LaskaKit/ESP32-C3_OLED_kit/img/LaskaKit-iot-oled-kit-2.jpg

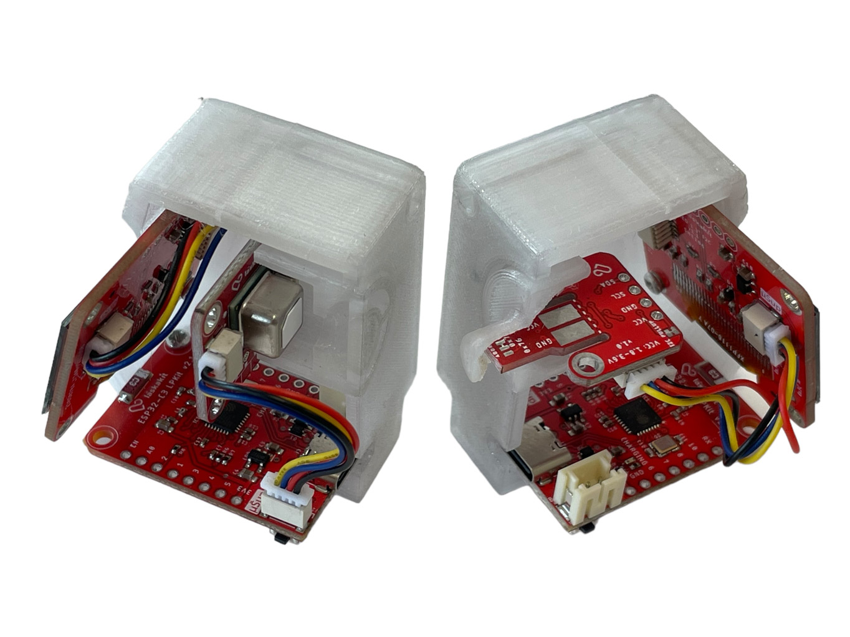
img/LaskaKit-iot-oled-kit-2.jpg
