LaskaKit/ESP32-C3_OLED_kit/img/LaskaKit-iot-oled-kit-6.jpg

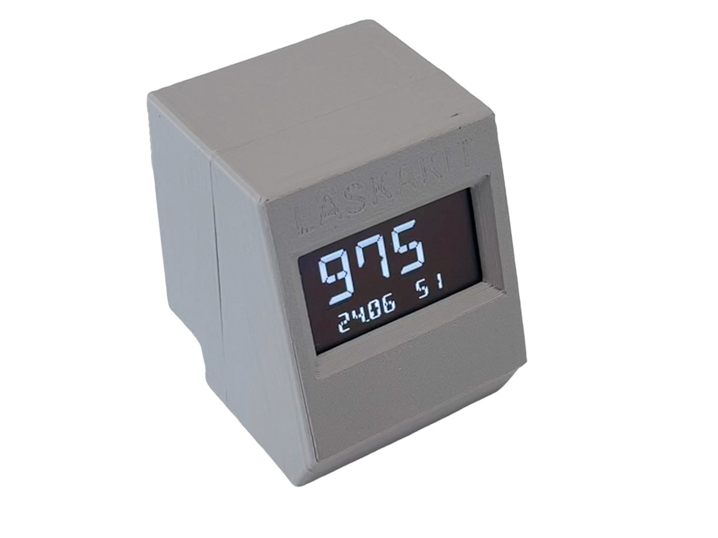
img/LaskaKit-iot-oled-kit-6.jpg
