LaskaKit/ESP32-C3_OLED_kit/3D/case_all.3mf

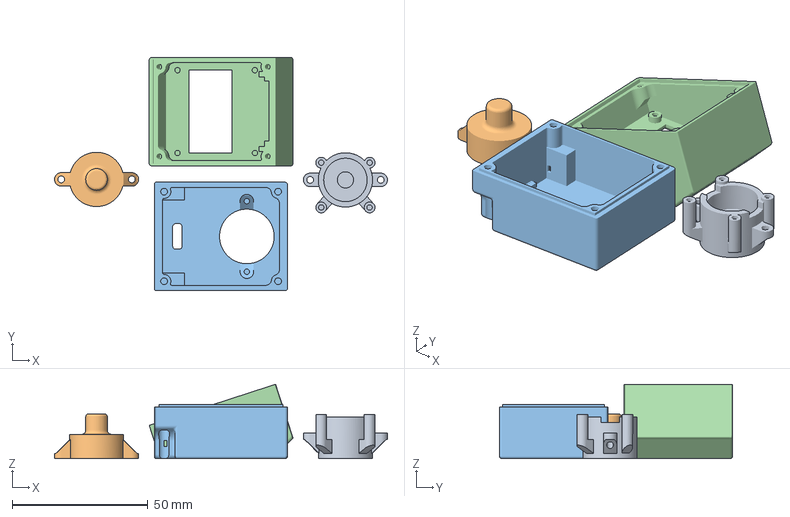
[picture p21: CAD file, 2025-03-09]
3D/case_all.3mf
122.7 x 86.0 x 27.4 mm
CO2_Holder v12.stl
temp_Holder v6.stl
back
front
